akseidel/LungTidalSonic/Images/BoxFront.png

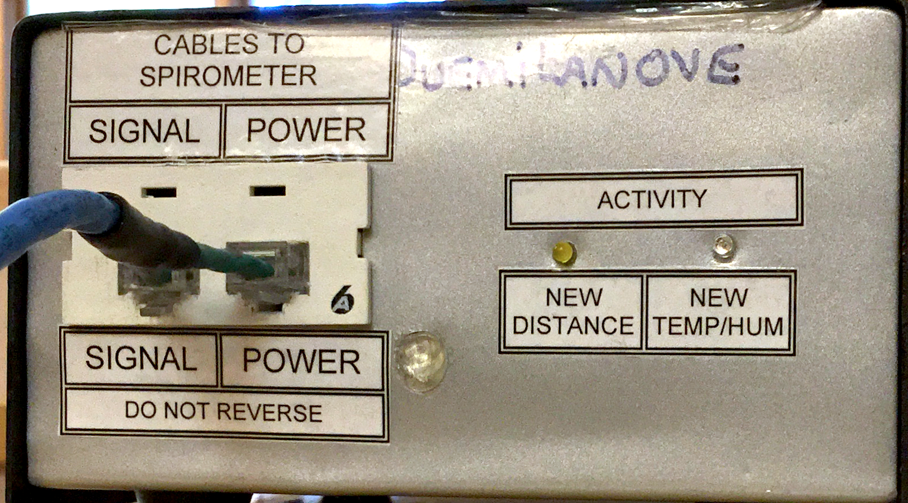
Images/BoxFront.png
