akseidel/LungTidalSonic/SourceCode/ProcessingSourceCode/LungTidalSonic/Data/calibration_data.tsv

# Spirometer calibration table
# 5/2018 modified for sonic readings
#
# Separate the data with tabs
# Use a text editor that writes raw text.
# <volume on dial><tab><raw analog data>
0	389.5
0.5	358.5
1.0	330.75
1.5	303.5
2.0	276.25
2.5	252.75
3.0	226
3.5	203
4.0	178.75
4.5	157.75
5.0	133.5
5.5	101.25
6.0	82.25
# calibration data end
#
# An alternate USB driver name can be placed here.
# LungTidal will try to use the USB driver name you
# place here if it cannot use the one it was compiled
# for. The format is USB:/the driver name
#
# example - USB:/dev/tty.usbserial-A800eGv4
#
# LungTidal shows the USB driver names it finds when it
# cannot find the one for which it is compiled or set here.
# Thus you can set the name for the USB driver it needs to
# look for in this file if you know for sure one of the
# drivers it lists as detected is in fact the one for the
# Arduino.
#
USB:/dev/tty.usbserial-A800eGv4
